condrea44/Square-Wave-Oscillator/Layout/layout.jpg

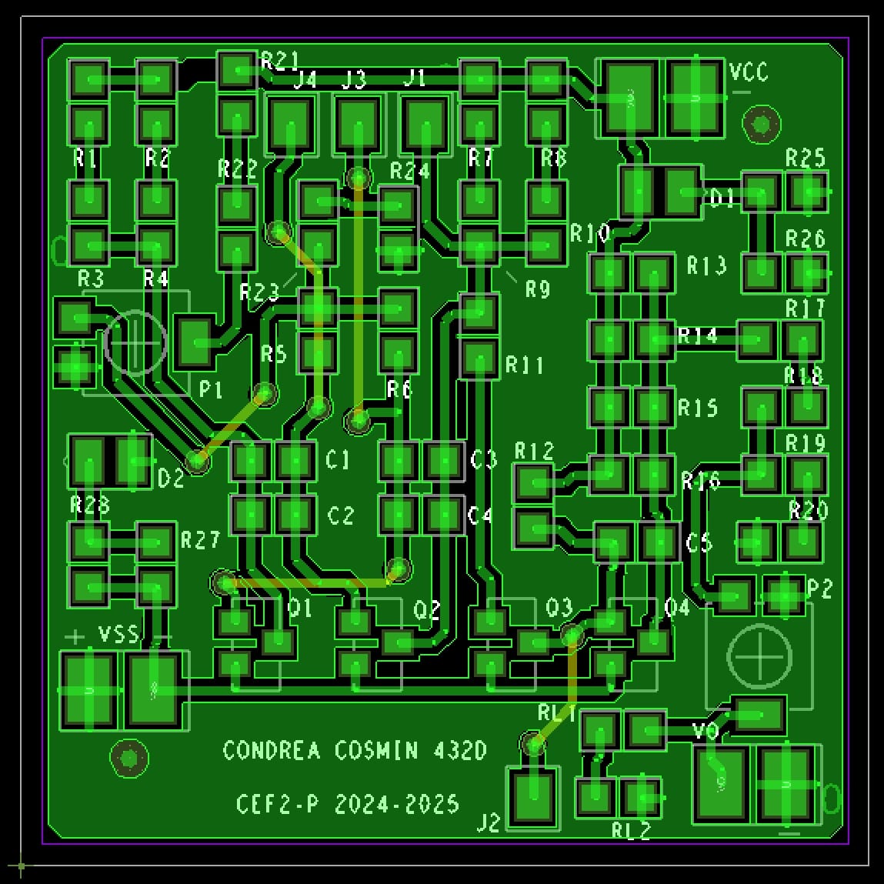
Layout/layout.jpg
