condrea44/Square-Wave-Oscillator/Schematics/proiect/P1_2024_432D_CONDREA_COSMIN_GSD_N9_ORCAD.png

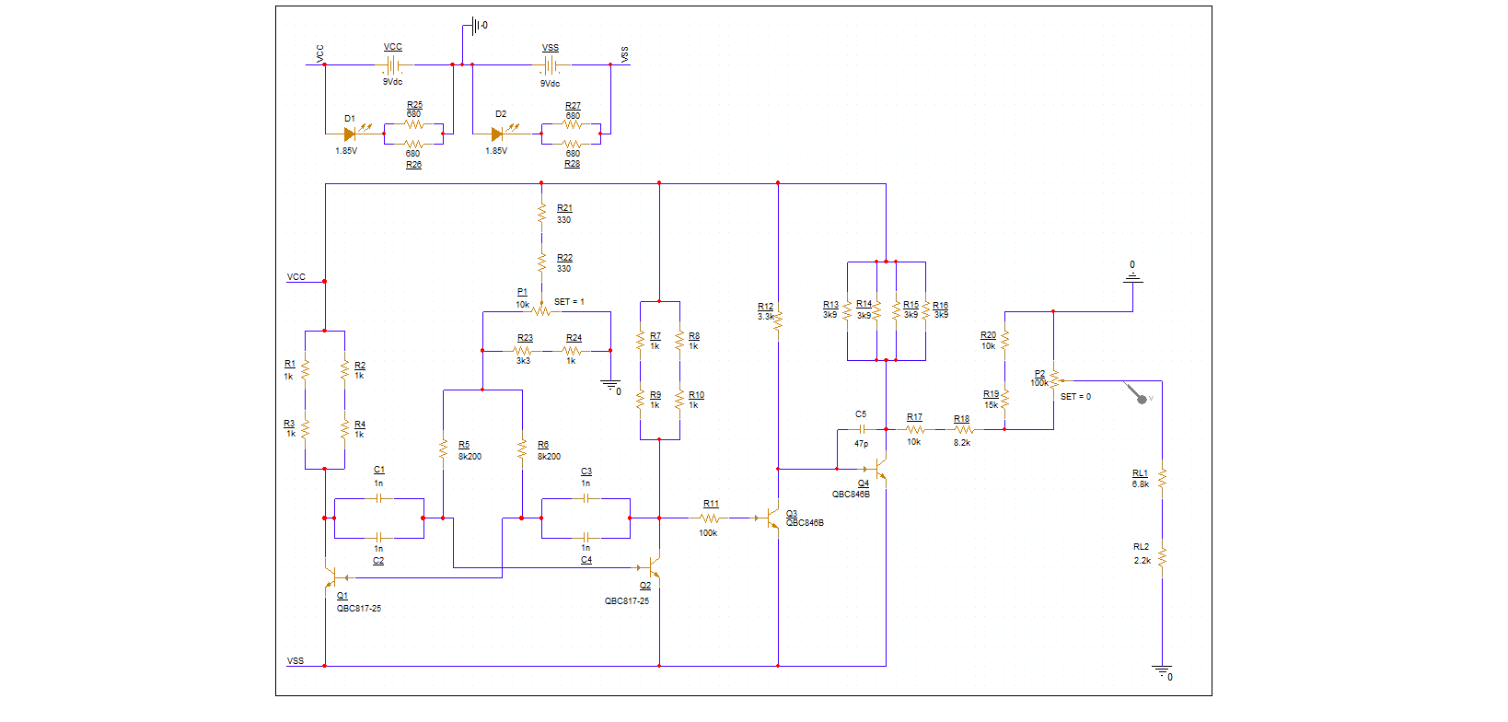
Schematics/proiect/P1_2024_432D_CONDREA_COSMIN_GSD_N9_ORCAD.png
