condrea44/Square-Wave-Oscillator/Schematics/schema_electrica.jpg

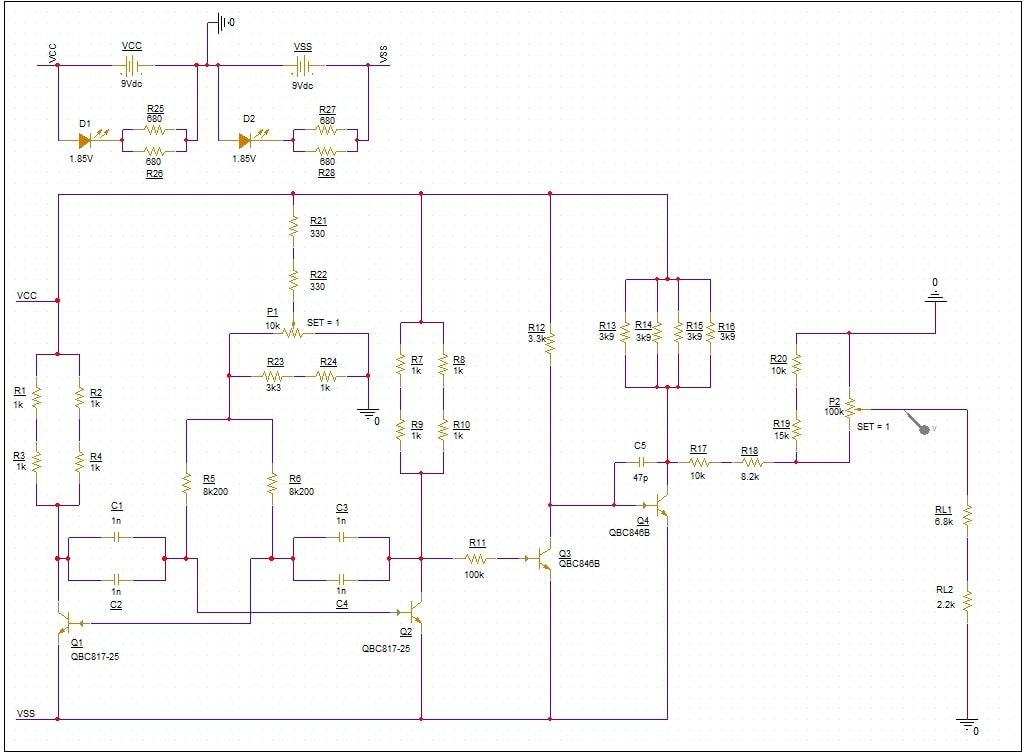
Schematics/schema_electrica.jpg
