condrea44/Square-Wave-Oscillator/Simulations/variatia_cu_temperatura.jpg

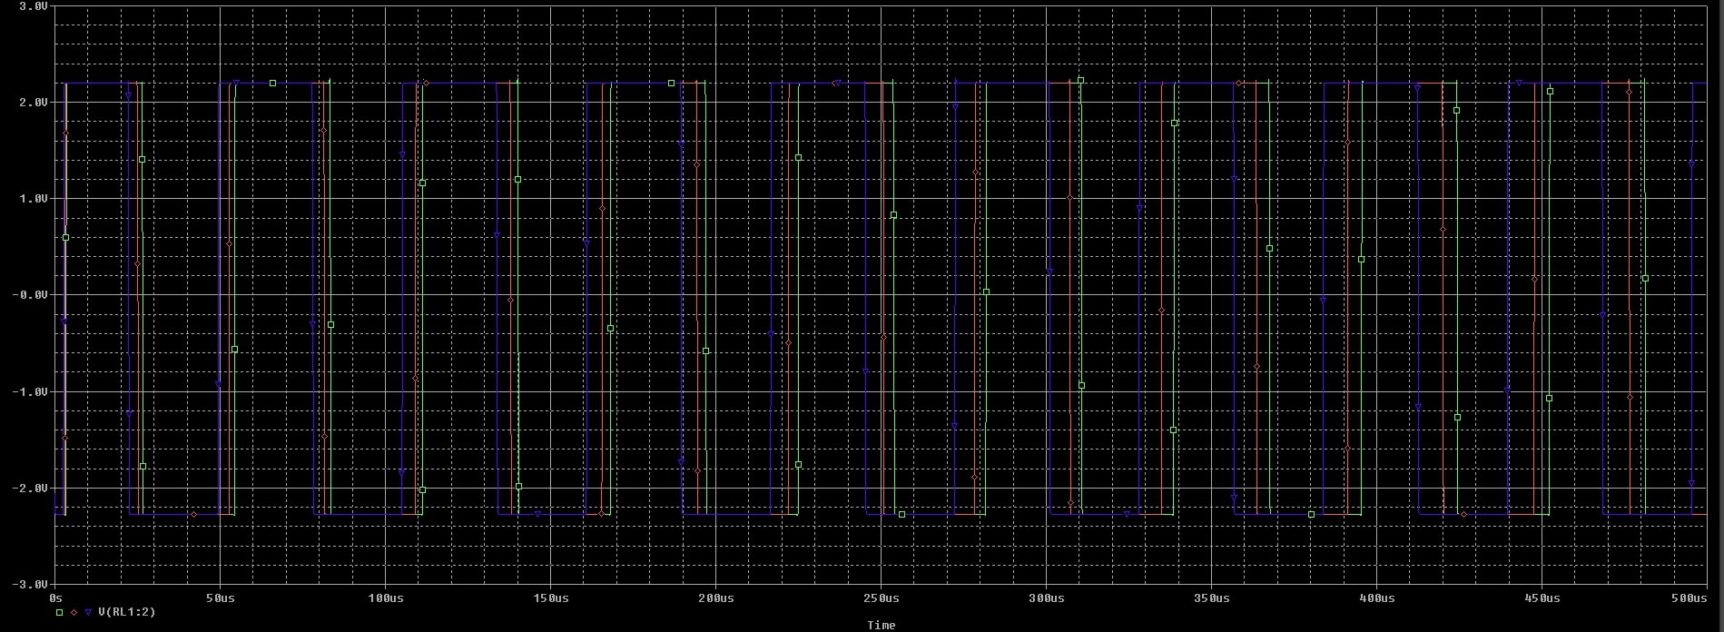
Simulations/variatia_cu_temperatura.jpg
