condrea44/Square-Wave-Oscillator/Simulations/Vout_P1_SET=1.jpg

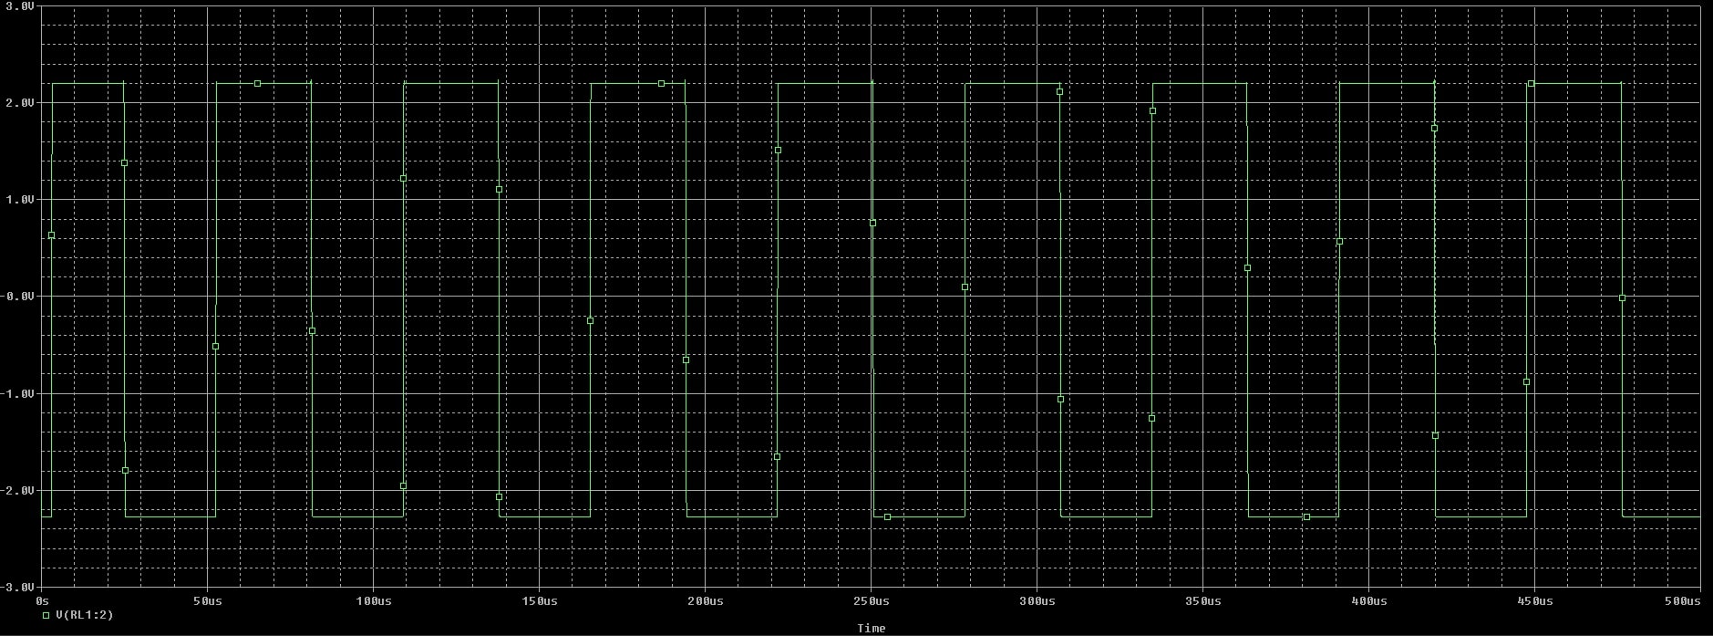
Simulations/Vout_P1_SET=1.jpg
