condrea44/Square-Wave-Oscillator/Simulations/Vout_P2_SET=1.jpg

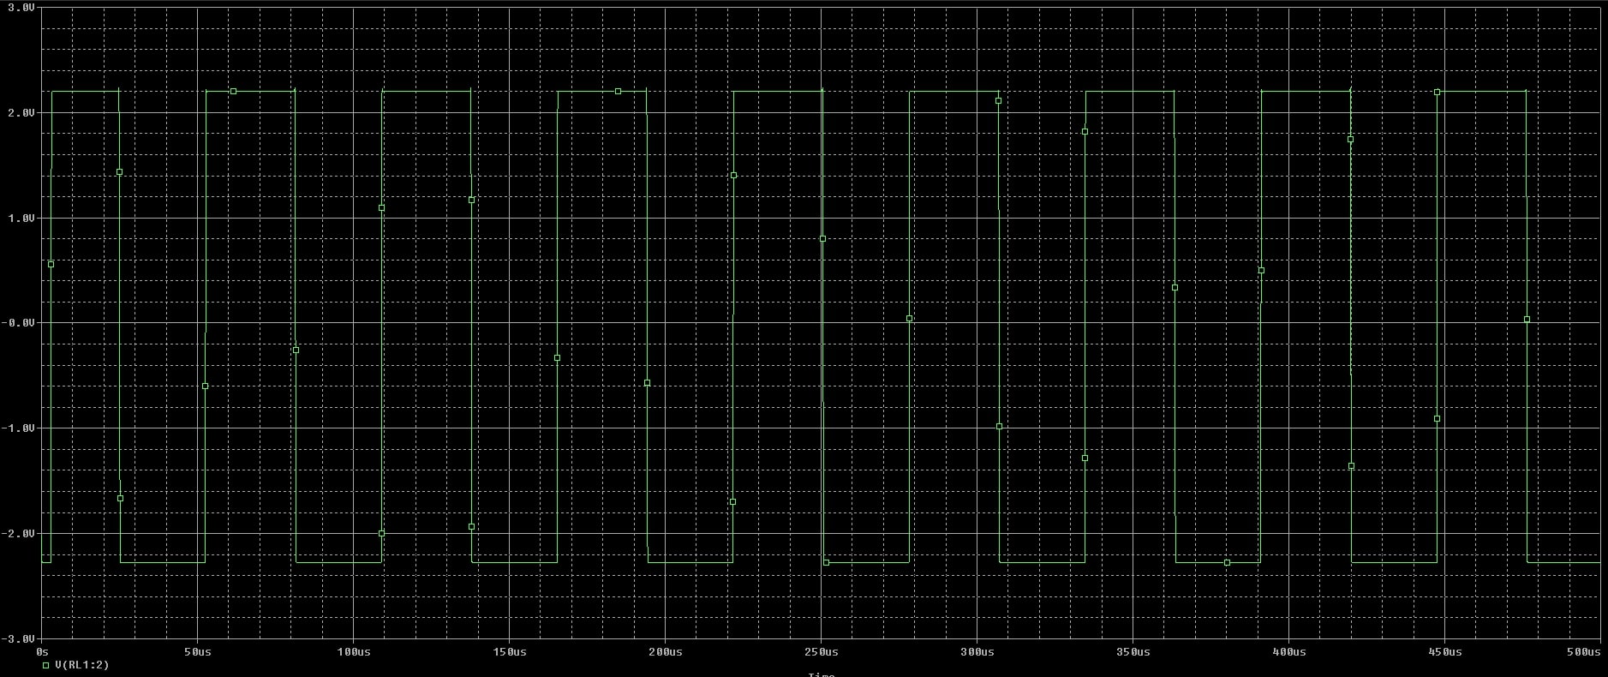
Simulations/Vout_P2_SET=1.jpg
