condrea44/Square-Wave-Oscillator/Schematics/proiect/p1_2024_432d_condrea_cosmin_gsd_n9_orcad-PSpiceFiles/SCHEMATIC1/Bode/Bode.cir

** Profile: "SCHEMATIC1-Bode"  [ C:\Users\cosmi\OneDrive - Universitatea Politehnica Bucuresti\Desktop\downloadad\P1_2024_432D_Condrea_Cosmin_GSD_N9_OrCAD\Schematics\proiect\p1_2024_432d_condrea_cosmin_gsd_n9_orcad-PSpiceFiles\SCHEMATIC1\Bode.sim ] 

** Creating circuit file "Bode.cir" 
** WARNING: THIS AUTOMATICALLY GENERATED FILE MAY BE OVERWRITTEN BY SUBSEQUENT SIMULATIONS

*Libraries: 
* Profile Libraries :
* Local Libraries :
.LIB "C:/Users/cosmi/OneDrive - Universitatea Politehnica Bucuresti/Desktop/downloadad/P1_2024_432D_Condrea_Cosmin_GSD_N9_OrCAD/Sch"
+ "ematics/lib_modelepspice_anexa_1/modele_a1_lib/bc817-25.lib" 
.LIB "C:/Users/cosmi/OneDrive - Universitatea Politehnica Bucuresti/Desktop/downloadad/P1_2024_432D_Condrea_Cosmin_GSD_N9_OrCAD/Sch"
+ "ematics/lib_modelepspice_anexa_1/modele_a1_lib/bc846b.lib" 
* From [PSPICE NETLIST] section of C:\Users\cosmi\AppData\Roaming\SPB_Data\cdssetup\OrCAD_PSpice\24.1.0\PSpice.ini file:
.lib "nom.lib" 

*Analysis directives: 
.AC DEC 1000 0.1 1G
.OPTIONS ADVCONV
.PROBE64 V(alias(*)) I(alias(*)) W(alias(*)) D(alias(*)) NOISE(alias(*)) 
.INC "..\SCHEMATIC1.net" 


.END
