condrea44/Square-Wave-Oscillator/Schematics/proiect/p1_2024_432d_condrea_cosmin_gsd_n9_orcad-PSpiceFiles/SCHEMATIC1/variatia_temperaturii/variatia_temperaturii.cir

** Profile: "SCHEMATIC1-variatia_temperaturii"  [ C:\Users\cosmi\OneDrive - Universitatea Politehnica Bucuresti\Desktop\P1_2024_432D_Condrea_Cosmin_GSD_N9_OrCAD\Schematics\proiect\p1_2024_432d_condrea_cosmin_gsd_n9_orcad-pspicefiles\schematic1\variatia_temperaturii.sim ] 

** Creating circuit file "variatia_temperaturii.cir" 
** WARNING: THIS AUTOMATICALLY GENERATED FILE MAY BE OVERWRITTEN BY SUBSEQUENT SIMULATIONS

*Libraries: 
* Profile Libraries :
* Local Libraries :
.LIB "C:/Users/cosmi/OneDrive - Universitatea Politehnica Bucuresti/Desktop/P1_2024_432D_Condrea_Cosmin_GSD_N9_OrCAD/Schematics/lib"
+ "_modelepspice_anexa_1/modele_a1_lib/bc817-25.lib" 
.LIB "C:/Users/cosmi/OneDrive - Universitatea Politehnica Bucuresti/Desktop/P1_2024_432D_Condrea_Cosmin_GSD_N9_OrCAD/Schematics/lib"
+ "_modelepspice_anexa_1/modele_a1_lib/bc846b.lib" 
* From [PSPICE NETLIST] section of C:\Users\cosmi\AppData\Roaming\SPB_Data\cdssetup\OrCAD_PSpice\24.1.0\PSpice.ini file:
.lib "nom.lib" 

*Analysis directives: 
.TRAN  0 0.5ms 0 0.1us SKIPBP 
.TEMP -20 25 100
.OPTIONS ADVCONV
.PROBE64 V(alias(*)) I(alias(*)) W(alias(*)) D(alias(*)) NOISE(alias(*)) 
.INC "..\SCHEMATIC1.net" 


.END
