condrea44/Square-Wave-Oscillator/(list of files, drawings)

Other design files:
Schematics/Lib_ModelePSpice_Anexa_1/Modele_A1_lib/1N4148.OLB
Schematics/Lib_ModelePSpice_Anexa_1/Modele_A1_lib/1n4148.opj
Schematics/Lib_ModelePSpice_Anexa_1/Modele_A1_lib/BC807-25.OLB
Schematics/Lib_ModelePSpice_Anexa_1/Modele_A1_lib/bc807-25.opj
Schematics/Lib_ModelePSpice_Anexa_1/Modele_A1_lib/BC817-25.OLB
Schematics/Lib_ModelePSpice_Anexa_1/Modele_A1_lib/bc817-25.opj
Schematics/Lib_ModelePSpice_Anexa_1/Modele_A1_lib/BC846B.OLB
Schematics/Lib_ModelePSpice_Anexa_1/Modele_A1_lib/BC856B.OLB
Schematics/Lib_ModelePSpice_Anexa_1/Modele_A1_lib/BZX84C2V7.OLB
Schematics/Lib_ModelePSpice_Anexa_1/Modele_A1_lib/BZX84C5V1.OLB
Schematics/Lib_ModelePSpice_Anexa_1/Modele_A1_lib/BZX84C5V6.OLB
Schematics/Lib_ModelePSpice_Anexa_1/Modele_A1_lib/BZX84C6V2.OLB
Schematics/Lib_ModelePSpice_Anexa_1/Modele_A1_lib/BZX84C6V8.OLB
Schematics/Lib_ModelePSpice_Anexa_1/Modele_A1_lib/BZX84C10.OLB
Schematics/Lib_ModelePSpice_Anexa_1/Modele_A1_lib/IRFR120NPBF.OLB
Schematics/Lib_ModelePSpice_Anexa_1/Modele_A1_lib/MJD31CG.OLB
Schematics/Lib_ModelePSpice_Anexa_1/Modele_A1_lib/MJD32CG.OLB
Schematics/Lib_ModelePSpice_Anexa_1/Modele_A1_lib/MMBFJ177LT1G.OLB
Schematics/Lib_ModelePSpice_Anexa_1/Modele_A1_lib/MMBFJ309LT1G.OLB
Schematics/proiect/P1_2024_432D_CONDREA_COSMIN_GSD_N9_ORCAD.DSN
Schematics/proiect/p1_2024_432d_condrea_cosmin_gsd_n9_orcad.opj
