condrea44/Square-Wave-Oscillator/(commit log)

2024-11-22 Initializare proiect
    [1N4148.OLB, 1n4148.opj, BC807-25.OLB, BC817-25.OLB, BC846B.OLB, BC856B.OLB, BZX84C10.OLB, BZX84C2V7.OLB]
2025-02-18 l-am actualizat
    [Anexa_a1_Grupa_432D.xlsx, LAYOUT.brd, p1_2024_432d_condrea_cosmin_gsd_n9_orcad.opj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]
